velkari/Automated-Chicken-Coop/README.md

# Automated-Chicken-Coop

## Project Members

*Eric Kinyanjui-EN292-0433/2013*

*Xavier Migwambo-EN292-3664/2013*

*Eugene Mwangi-EN292-0469/2013*
